wesleydjds1-max/Sensor-de-Odor/case_3d/Case Sensor Odor - Base.stl

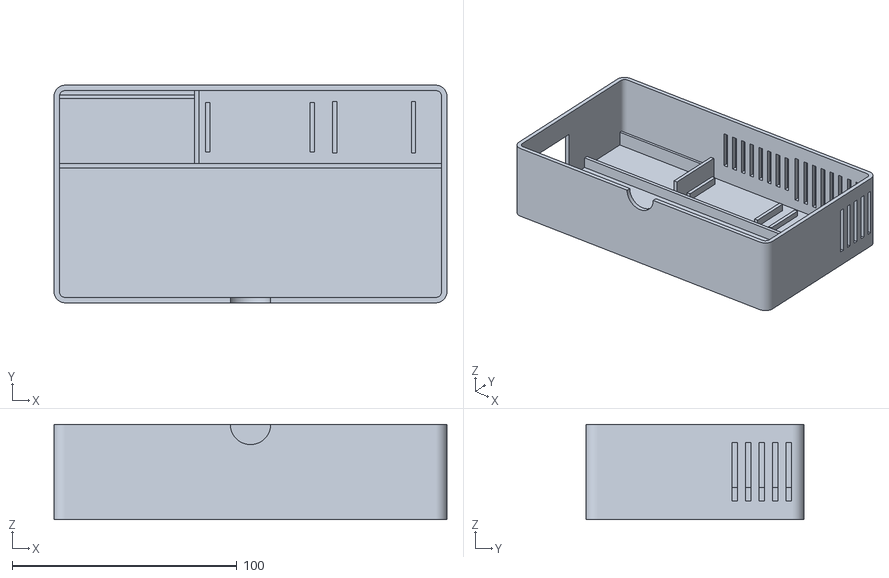
[picture p2: CAD file, 2026-11-10]
case_3d/Case Sensor Odor - Base.stl
174.8 x 96.8 x 42.4
